onedino/ADC_DAC_Board/ADC_DAC_TODO.txt

RS pin not connected on DC motorboard and ADC board need to add pull down resistor in v1.0
