onedino/ADC_DAC_Board/(list of files, drawings)

Other design files:
ADC.SchDoc
ADC_DAC2021.PrjPcb
DAC.SchDoc
Power.SchDoc
STM32F405.SchDoc
top.SchDoc
