onedino/ADC_DAC_Board/(commit log)

2021-01-08 version 1.0
    [ADC.SchDoc, ADC_DAC2021.PrjPcb, DAC.SchDoc, Power.SchDoc, STM32F405.SchDoc, top.SchDoc]
2021-01-09 added common choke for isolator and add top layer AGND plane
    [ADC_DAC2021.PrjPcb, top.SchDoc]
2021-01-17 changed CAN bus connector and removed floating polygon
    [ADC.SchDoc, Power.SchDoc, STM32F405.SchDoc]
2021-01-28 Fixed RS resistor on CAN bus transceiver
    [STM32F405.SchDoc]
